ZEX0610/CareRover/main-web/docs/wireless-acceptance.md

> 本文描述原 `integration=legacy` 无线阶段。新人物/运动集成见 [跟随开发说明](tracking-development.md)；软件验证与真机验收分别记录。

# 无线阶段验收记录

本文件区分代码证据与真机证据。当前所有硬件场景均 **待 Windows 验收**；没有把本地模拟或编译当成真机通过。

| 阶段 | 代码与本机验证 | Windows 真机状态 |
|---|---|---|
| 0 基线 | 交接网页适配已合并；测试通过；原分区表已固定 | 待原工程配置、原固件重新编译结果 |
| 1 AP | 已实现，包含安全任务和串口诊断 | 待连接热点及原传感器/OLED回归 |
| 2 FFat HTTP | 已实现；镜像生成并反向解析逐文件校验 | 待实际挂载、独立供电网页加载 |
| 3 只读 WS | 已实现；25 Hz PPG、独立新鲜度、立即 ping | 待 10 分钟真机只读报告 |
| 4 控制 | 已实现；仅测试目标，拒绝自主模式 | 待真实 `/ws` ACK/目标回显检查 |
| 5 安全 | 固件共享逻辑主机测试及 20 组故障断控断言通过 | 待硬件 20 组报告、物理断网/掉电/拥塞测试 |

## 本机验证方法

- `npm test`：网页既有行为，以及 null 清除、控制者权限、新鲜度独立、错误关联。
- Python unittest：USB 适配、模拟器网络回归、烧录配置/分区/载荷边界。
- C++：直接测试固件状态机，包含命令边界、CAM 独立超时、模式清零、权限、急停跨连接、故障优先级、64 位时钟、深度和帧大小保护。
- ESP32 编译：明确未核实的 Core 3.3.10 / SparkFun 1.1.2 开发配置，仅证明可编译。
- 浏览器：Mock 回归与注入测试遥测的 UI 验证；不宣称来自真机。

## 每次现场记录

```text
提交：
固件版本 / 网页版本：
Windows FQBN / Core / 传感器库版本：
主控型号及 Flash/PSRAM：
stage：
供电方式、是否断开主控 USB：
测试浏览器和设备：
结果：PASS / FAIL / NOT RUN
证据路径或日志摘要：
```

## 阶段门槛

1. 原主控重新编译成功；保存恢复镜像。新代码先 AP、再 HTTP、再只读 WS，逐级烧录验收。
2. 主控和 CAM 独立规范供电，无主控 USB；手机能连热点、访问完整页面；无互联网仍可用。网页串口诊断协议链接、JS/CSS、版本文件都能加载。
3. 连续 10 分钟读取；手势变化 2 秒内与 OLED 一致；HR、SpO2、SQI 与 OLED/串口一致；PPG 连续，采样率和批次正确。
4. 移开手指、弱信号、拔 MAX30102：旧 HR/SpO2 不继续显示为有效。拔 CAM：camera=false、手势失效；健康和安全任务继续工作；接回 CAM 不自动恢复 MANUAL。
5. 两个浏览器：只有所有者可控制；另一个按钮只读且固件返回 CONTROL_BUSY，但仍可急停。跟人/手势驱动返回 UNSUPPORTED_MODE。
6. 20 次测试后端异常：记录每次停止原因、设备最后命令时间与停止时间。任何超过 250 ms、保留非零目标或自动恢复运动都失败。
7. 人工分别关闭页面、断手机 Wi-Fi、断浏览器设备电源、停止发命令、刷新急停页面、断开所有者。恢复连接后保持零目标；急停锁不自行解除。
8. 并发重复加载网页、慢读 WS、Wi-Fi 干扰：允许网络降低刷新或断开，采样不中断，安全任务间隔不超过预留 10 ms、命令超时归零不超过 250 ms；若不满足，记录并修复后重测。
9. FFat 无载荷或损坏场景使用专门测试板/已有备份：串口明确报错，不自动格式化。恢复正确载荷后重新验证。

任一失败保留 FAIL，不用重跑成功结果覆盖故障记录。先定位、修复、关联新提交再复测。只有阶段 0–5 全部通过才可完成总 goal；实际执行器验证属于后续目标。

## 2026-09-11 本机执行结果

- 网页 Node：11/11 通过；Python：16/16 通过。
- C++ 固件状态机/帧保护：全部断言通过，含 20 组独立故障场景。
- ESP32 Core 3.3.10 + SparkFun 1.1.2：stage 5 编译通过，使用 compile_only 配置；无设备连接、未烧录。
- FFat：镜像反向解析，所有生成的网页文件逐字节一致。
- Playwright：Mock 无控制台错误；注入测试遥测验证立即 ping、只读权限、自主模式禁用和独立 null 清除；桌面与 390px 手机视口已检查。该浏览器验证不使用真机数据。
- 现场只读 soak、真实 `/ws` 异常矩阵与物理故障测试：NOT RUN。
