ZEX0610/CareRover/watch-prototype/docs/LOCAL_PROGRESS.md

# 本机开发进度 · 2026-09-24

## 已核实

- 用户确认电池为 3.7 V 250 mAh，照片为带保护板 602025，约 26×20×6 mm。
- 用户确认 MAX30102 贴右腕手背侧皮肤。
- 本地电源板商家图片、MAX 模块手册/2D 图/原理图、MPU6050 资料、ESP32-S3 Zero 资料已检查。MAX 原理图显示 I²C 外侧可能上拉到板内 5 V，因此直连 3.3 V GPIO 处于待电气验证状态。
- 独立手表草图、运动算法、PPG 演示估计、协议和现场验收文档已写入本目录；没有修改小车两板固件。
- 本机 C++14 回归测试通过：模拟抬臂、归中、左右肩转、正反手腕横滚、IMU 180 ms 超时；合成 PPG 约 75 BPM、91% 演示 SpO2；协议生成/缓冲区边界通过。
- Arduino CLI 对 `esp32:esp32:waveshare_esp32_s3_zero` 编译成功（esp32 3.3.10、SparkFun MAX3010x 1.1.2）：448148 B 程序、33312 B 全局 RAM。首次构建使用中文输出路径在链接时失败，换英文临时 `--build-path` 后成功；详情见 README。

## 尚未核实

- 设备未到货，故不存在真实 GPIO、I²C、电流、充电、佩戴 PPG、Wi-Fi 丢包和运动方向实测通过。
- 小车主板没有 `watch_v1` 接收器；网页/OLED 也没有手表数据源显示。留待手表台架通过后集成。

## 下一次接续从这里开始

1. 到货后先量电源板 USB 充电/升压输出和 MAX SDA/SCL 空闲电平，再决定能否直连。
2. 按 `WIRING_AND_BENCH_PLAN.md` 的六级顺序做实物验收，留存波形、电流、温度、动作方向与无线包间隔。
3. 手表稳定后，才按 `INTEGRATION_CONTRACT.md` 修改小车主控及网页/OLED，先架空车轮验收。
