ZEX0610/CareRover/watch-prototype/max_schematic_review.png

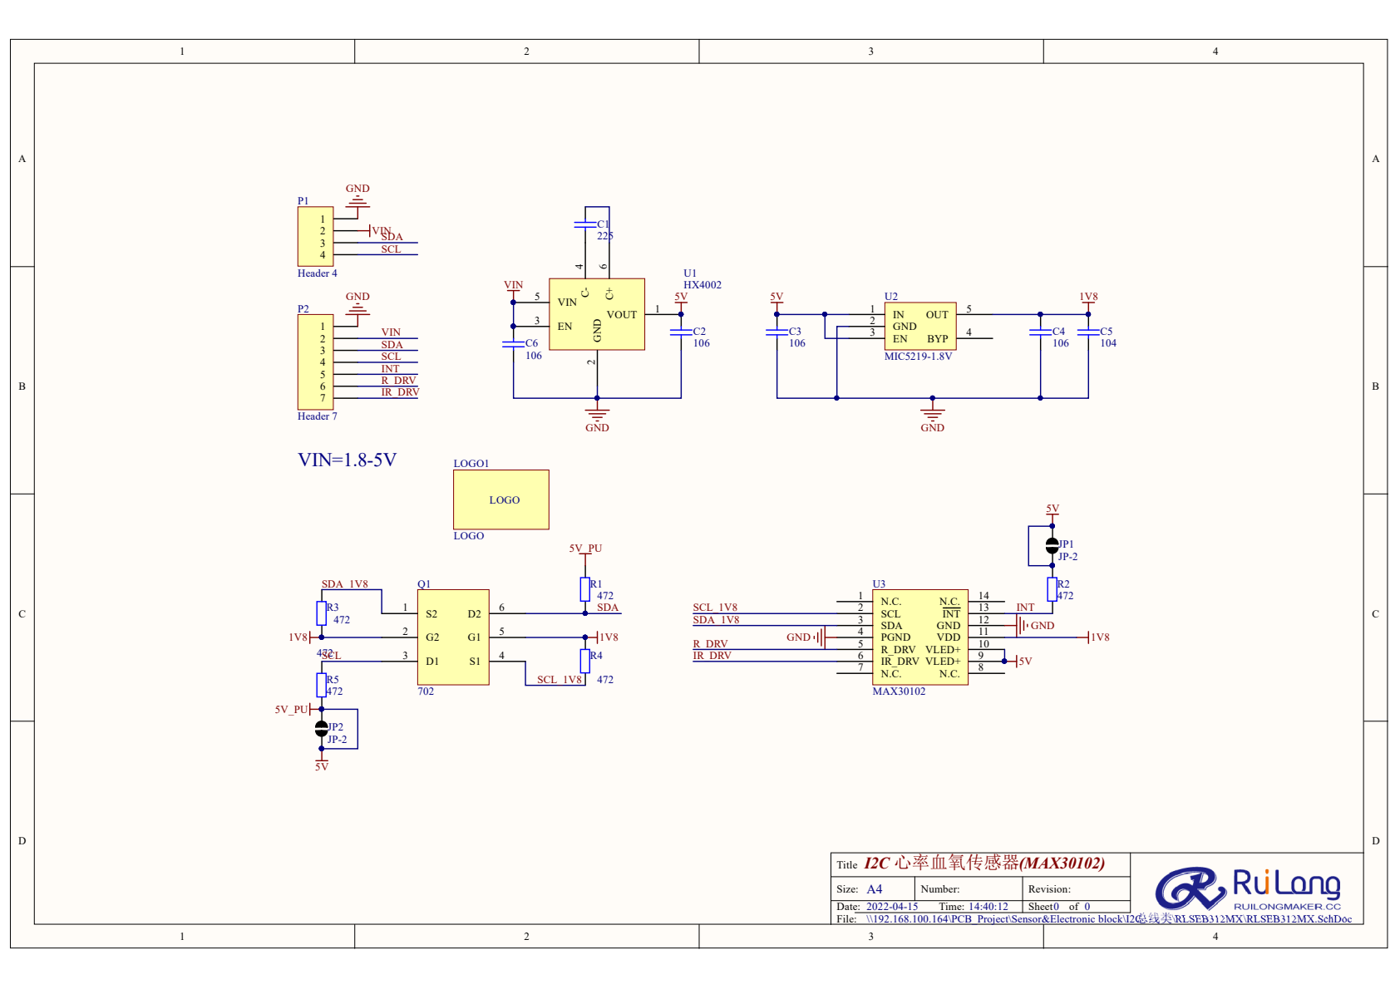
watch-prototype/max_schematic_review.png
