ZEX0610/CareRover/watch-prototype/docs/WIRING_AND_BENCH_PLAN.md

# 腕带结构、接线与到货后的逐级测试

## 1. 先确定机械姿态

面向佩戴者：右手向前平举、手背向上；MPU6050 与手背保持相对固定。目标传感器坐标为 `+X` 指向手指、`+Y` 指向右手拇指、`+Z` 远离皮肤。实际 GY-521 板上的 X/Y 丝印方向若不符，优先调整安装，不能凭照片默认为正确；装反时在软件里做三轴符号/轴置换再重新测试。

建议沿前臂长轴依次布置：腕部内侧窗口为 MAX30102，背皮肤侧仅留感光开口及柔软遮光圈；其 PCB 其他元件与皮肤间加薄绝缘/缓冲。MPU 固定在外壳平面，避免线材拉扯使其相对手臂摆动。ESP32-S3 Zero 天线端放在远离电池金属保护板及身体的一端，USB-C、BOOT 和电源开关均可从外壳外触及。电池与电源板隔离安放，禁止硬板边缘压迫软包电池。先做松散台架，再定制外壳；不建议在尺寸和发热未验证前上下叠压紧贴皮肤。

资料尺寸：电池照片为约 26×20×6 mm；ESP32-S3 Zero 官方尺寸约 23.5×18 mm；电源板商家图约 30×10×9 mm；MAX 商家手册写 26×41 mm，而 2D 图给出了 36、26、30 mm 标注，**以到货尺量为准**。佩戴宽度可能主要受 MAX 模块决定。

## 2. 电气接线表（先验证，后永久焊）

| 源 | 去向 | 备注 |
|---|---|---|
| 602025 电池红/黑 | 电源板 `B+`/`B-` | 先核对正负极和电池保护板。不要焊接/短接电池本体。 |
| 电源板经开关后的**实测 5 V** 输出和 GND | ESP32-S3 Zero `5V` 与 `GND` | 商家板标有 `M+ / M-`、`U+ / U-`；实物未测前不能认定哪对是 5 V 或受开关控制。**不可**把 3.7 V 电池直连 5V 焊盘，也不可把 5 V 接 3V3。 |
| ESP32 `3V3`、`GND` | MPU `VCC`、`GND` | 共地；尽量短线、固定防拉断。 |
| ESP32 `GPIO4`、`GPIO5` | MPU `SDA`、`SCL` | MPU `AD0` 接 GND（0x68），`XDA/XCL/INT` 留空并绝缘。 |
| ESP32 `3V3`、`GND` | MAX 模块 `V/VCC`、`G/GND` | MAX 四脚排针定义为 G、V、D、C；只在供电/纹波测量合格后焊。 |
| ESP32 `GPIO4`、`GPIO5` | MAX 模块 `D/SDA`、`C/SCL` | **仅当空闲 SDA/SCL ≤3.3 V 时可直连**；否则先改造 5 V 上拉或加入小型双向电平转换器。 |

### MAX 模块需要特别量电压

商家原理图 `RLSEB312MX_SCH.pdf` 表明：模块将 VIN 升为内部 5 V，I²C 外侧的 SDA/SCL 经 472 上拉到 `5V_PU`，`JP2` 连接 `5V_PU` 与内部 5 V。故“VCC 接 ESP32 3.3 V”**不意味着**数据脚为 3.3 V。先不接 ESP32 的 SDA/SCL，只给 MAX 模块 VCC/GND 供电，以万用表量 SDA、SCL 对 GND 的空闲电压。高于 3.3 V 时，优先在外部使用双向 I²C 电平转换器（MAX 侧 HV=实测 5 V、ESP32 侧 LV=3.3 V，并共地）；若采用拆除 JP2、更换上拉的精细改板方式，必须看实板、断电测通断、上电复测两线 ≤3.3 V。未确认前不直连 GPIO。不能将 ESP32 3V3 接到 MAX 内部 5 V 电源节点。

原理图已渲染为本目录上一层的 `max_schematic_review.png`，可直接放大看 JP2、R1/R5 与 MOS 电平转换部分。

电源板卖家只给了图片，没有明确的充电电流、升压峰值、欠压策略。250 mAh 电芯所允许的充电电流须以电池和电源板规格及实测为准；未确认前只做 USB 限流台架检查，**不要边充电边佩戴**。首次上电检查空载 5 V、3.3 V，随后检查 ESP32 Wi-Fi 连接/发送瞬态电压及电源板温升。USB 电脑连接与外部 5 V 同时存在时，若板上无明确电源隔离电路，先断开外部升压 5 V 再插 USB 调试，避免 5 V 反灌。

## 3. 直焊导线而非排针

台架先用临时线和绝缘夹具验证全部引脚。确认无误后，用细软硅胶线对每个焊盘点焊、热缩管单独绝缘，并在 PCB 边缘做应力释放。红/黑分别标记正负，SDA/SCL 用不同颜色；每根线接线后用万用表查短路及拉力。贴肤面用不透光、低刺激且可拆洗的遮光垫圈包围感光窗口；镜片不应被胶封住。留透气与散热间隙，不让热的电源板贴皮肤。穿戴与运动数据测试先用低功率 USB/实验电源完成，最后再接电池。

## 4. 分阶段验收，不跳过失败项

1. **空载电源**：量电池极性、板上各焊盘电压、开关关断后的输出、USB 充电电流及板温。任何 5 V 欠压/过压、异常发热先停。
2. **仅 ESP32**：用 USB 在 Arduino IDE 烧录串口草图，115200 确认 `watch_v1`、BOOT 短按释放时 `RECENTER`。断 USB 后改由升压 5 V 单独供电，测 Wi-Fi 发包时 5 V 与 3V3 最低值、平均/峰值电流和重启次数。
3. **仅 MPU**：确认 I²C 地址 0x68、坐标轴符号；水平前举静止约 1 秒完成归中，再做抬/落、左右肩旋转、双向手腕横滚。抓取串口 JSON，逐项看 `vx/vy/wz` 符号、180 ms IMU 失联清零、再次归中。记录陀螺零漂，尤其左右控制在 30 秒内是否需要归中。
4. **仅 MAX**：先测 SDA/SCL 高电平，再接 I²C。检查 0x57、实际 FIFO 25 Hz、有手腕/无手腕的 IR DC、波形和接触噪声。静坐至少 2 分钟，与可信指夹式仪器比对 HR/SpO2；再分别做轻摆、剧烈动作、松紧带变化，记录“当前有效”“保持上次值”“无数据”的变化。若腕部 SpO2 偏差大，不得以降低阈值掩盖偏差；可展示 HR 和波形，SpO2 标记演示/未校准。
5. **联合供电**：MPU+MAX+Wi-Fi 同时运行 10 分钟，记录 I²C 失败、FIFO 溢出、串口包间隔、掉线重连、最大温升和电池耗电。用实际平均电流估算续航：约 `250 mAh ÷ 实测 mA`，再为升压损耗与电压截止留余量，不凭容量数字宣称续航。
6. **穿戴动作与无线**：每种动作 20 次，确认指令方向和静止误触率。由于六轴不能长期观测绝对航向，左右肩转控制采用短时相对角；换站位/漂移时按 BOOT 归中，量化归中间隔。此阶段通过后再修改小车固件。
