ZEX0610/CareRover/audio-lab/docs/WIRING_AND_TEST.md

# 音频模块接线、电源与现场分阶段验收

## 与当前小车的引脚对照

从 `C:\CareRover\docs\wiring-current.md` 和主板实际 `front_config.local.h` 核对：OLED=4/5，MPU6050=6/7，MAX30102=8/9，四轮=10/12/13/11，HC-SR04=14/15，CAM UART=17/18，原生 USB=19/20。现场确认 INMP441 的 SCK/WS **已经**分别占用 GPIO1/2，用户不希望把功放时钟再接到这两脚。主板引脚图在 `ESP32-S3开发\ESP32-S3开发板\ESP32-S3引脚图1.png`；功放选用 GPIO39/42，当前其他固件功能未占用。**接线前仍需按手里的同款主板丝印复核**；GPIO39/42 若将来启用外部 JTAG，则需要重新分配。

| 信号 | 独立实验 ESP32-S3 主板 | INMP441 / MAX98357 模块 |
|---|---:|---|
| 麦克风 I²S BCLK/SCK | GPIO1（已接） | 仅接 INMP441 `SCK` |
| 麦克风 I²S WS | GPIO2（已接） | 仅接 INMP441 `WS` |
| 麦克风数据输入 | GPIO16 | INMP441 `SD` → GPIO16 |
| 功放 I²S BCLK | GPIO39 | 仅接 MAX98357 `BCLK` |
| 功放 I²S LRC/LRCLK | GPIO42 | 仅接 MAX98357 `LRC/LRCLK` |
| 扬声器数据输出 | GPIO21 | GPIO21 → MAX98357 `DIN` |
| 功放开关 | GPIO38 | GPIO38 → 1 kΩ → 功放 `SD/SD_MODE`；`SD` 对 GND 加 10 kΩ 下拉，防止开机时默认响 |
| 麦克风声道 | — | INMP441 `L/R` → GND（左声道） |
| 麦克风电源 | 主板 3.3 V | `VDD/VCC` → 3.3 V，`GND` → 主板 GND；**不能接 5 V** |
| 功放电源 | 新电源模块独立 5 V | `VIN/VCC` → 新模块 5 V，`GND` →公共 GND |
| 扬声器 | — | 3 W/8 Ω 扬声器两线分别接 `OUT+`、`OUT−`；**任一喇叭线都不能接 GND** |

麦克风 RX 用 I²S0，功放 TX 用 I²S1，分别由现有 GPIO1/2 与新增 GPIO39/42 输出时钟；**四根线都单独接，不共接任何时钟 GPIO**。两路音频通过队列交换 20 ms 帧，并不要求两组时钟物理同步。不需要 MCLK。模块原理图 `MAX98357_TEST扬声器\MAX98357_TEST\原理图.png` 标明 SD_MODE 有 1 MΩ 上拉、GAIN 悬空（9 dB）、OUTP/OUTN 为桥接输出；若实物板的丝印/元件与图不同，以实物核查为准。MAX98357 **A** 接标准 I²S；若实物芯片尾字是 **B**，B 型的数据格式不同，应先确认型号再上电。商家旧图使用经典 ESP32 的 GPIO22/25/26/34，不能照搬到本项目 ESP32-S3。麦克风本地规格书在 `INMP441全向麦克风资料(1)\INMP441全向麦克风资料\INMP441.pdf`，供电允许 1.62–3.63 V，输出为 24 位数据、32 位声道槽，因此实验固件用 16 kHz×双声道×32 位，即每路 1.024 MHz BCLK。[TDK 原规格书](https://invensense.tdk.com/wp-content/uploads/2015/02/INMP441.pdf)、[ADI MAX98357 规格书](https://www.analog.com/media/en/technical-documentation/data-sheets/MAX98357A-MAX98357B.pdf)、[乐鑫双向 I²S 文档](https://docs.espressif.com/projects/esp-idf/en/latest/esp32s3/api-reference/peripherals/i2s.html)。

## 两块电源模块怎么分

```text
旧模块 5 V ── 四个 MG90S 舵机（现有线路，原样保留）
新模块 5 V ── MAX98357 功放 VCC（先只给音频功放供电）
主板 USB 或已验证的主板电源 ── ESP32-S3 ── 3.3 V → INMP441
旧模块 GND ─┬─ 主板 GND ── CAM/传感器 GND
新模块 GND ─┘
```

两路 **GND 共地**，旧/新模块的 **5 V 正极互不相连**、3.3 V 输出也不并联，扬声器两线只接功放输出。当前 USB 调试主板/CAM 时，USB 的 5 V 与新旧模块 5 V 不相接；不能从两处同时灌同一 `5V` 引脚。今后脱离 USB，应先现场明确主板与 CAM 各自的稳压供电额定能力、保险/开关和电源分配，再决定是否迁移；不能因为多买一块电源就默认四舵机、CAM、主板和功放能同时稳定工作。

用户给出的扬声器是 **3 W/8 Ω**。3 W 是扬声器承受能力，不等于该功放在 5 V/8 Ω 能给出 3 W；MAX98357 数据表给出的 8 Ω 典型输出约 **1.8 W（10% THD+N）**。新模块每个 5 V 口、升压总路、电池瞬态能力要以实测为准，开始时用实验固件的 `/6` 幅度、功放默认 9 dB，不要直接满幅。[ADI 规格书](https://www.analog.com/media/en/technical-documentation/data-sheets/MAX98357A-MAX98357B.pdf)

布线建议 I²S 线尽量短（首测 <10 cm，最终尽量 <15 cm），BCLK 附近有地线返回；功放/扬声器线与麦克风分开走，麦克风远离舵机和喇叭、避免喇叭正对收音孔。必要时在功放 5 V 近端加 100 µF 以上低 ESR 储能电容及 0.1 µF 去耦；商家板已有 0.1 µF/10 µF，但长线和电源脉冲仍要示波或万用表核查。

若直接焊线而不装排针：先断电核对焊盘丝印、导线颜色和极性，再给线根部热缩/点胶做应力释放；通电前用万用表确认 3.3 V、5 V、GND 互无短路，扬声器两线与 GND 绝缘。不要把数据表芯片脚号当成商家模块焊盘顺序。

## 阶段测试（每步记录 PASS/FAIL/NOT RUN）

1. **不接现有整车**：借用备用同型号 ESP32-S3 主板或预先备份后明确允许临时替换固件；把扬声器和功放 5 V 先断开。核对 VDD/GND、模块 A/B 版本、喇叭标签、空闲 GPIO、两路 5 V 无相通。
2. Arduino IDE 选 ESP32S3 Dev Module / 16 MB Flash / OPI PSRAM / 115200，编译并上传**独立草图到备用板**。串口输入 `mic`，说话、安静各 10 秒；预期 `capture_fps≈50`，`mic_rms` 对说话有明显变化。若一直 0，先查 L/R 接地及 GPIO16，而非增大扬声器功率。
3. 功放新模块 5 V 上电，先查主板 3.3 V 与功放 5 V 稳定、共地、SD 默认被 10 kΩ 拉低。串口输入 `tone`，预期低音量 440 Hz；`idle` 应静音。输入 `loop` 可短时自听，喇叭与麦克风分开以免啸叫。记录 5 V 波动、重启、噪声、温升。
4. 本机先跑 `npm test` 验证协议。配置公网 HTTPS/WSS 中继与两个独立随机令牌；把备用板设为 `remote`，用另一台设备打开中继 HTTPS 页。测试“孩子说→家长听”“家长按住→小车播”“家长松开→小车不再播”，各 1 分钟；记录端到端时延、断线恢复、音频缺口/回声。当前音频固件 `remote` 采用 **纯 STA**，不会承载小车现有 AP/视频/控制；这是隔离验证，不代表整车集成。
5. **以后才做整车集成**：先保存两板 Flash/NVS 与网页版本；在现有主板固件里接入 I²S/队列/WSS，并保留 AP+STA/Server酱、CAM 与控制协议。比较加音频前后视频实际帧率、人物/手势推理、摇杆 P95 延迟、最低空闲堆、掉帧/断线、舵机电压与消息推送。测试观测期至少 10 分钟，包含真实小车运动、跟随、双向说话。当前这一步 **NOT RUN**。

音频有回声时先改半双工按住说话、麦克风/扬声器位置和物理隔声。要真实免提同时说话，需加入 AEC 并复测 CPU/PSRAM；不能把单麦克风+单功放的裸 PCM 原型称为已完成高质量全双工通话。
