ZEX0610/CareRover/main-web/docs/test-checklist.md

# 验收记录

日期：2026-09-09。范围：本地 Mock 控制台，未接入真实硬件。

## 自动检查

执行：

```bash
node --test tests/*.test.js
.venv/bin/python -m unittest discover -s tests -p 'test_*.py' -v
```

当前覆盖 8 项 Node 测试、5 项 Python 测试：

本地两套检查均通过；功能提交 `00a7e5a` 的 [GitHub Actions 检查](https://github.com/NeedleAss/spider-webite-dev/actions/runs/34332275913) 在 Ubuntu / Node 22 / Python 3.12 上同样通过。

- [x] 4:3 源图像在 16:9 / 纵向容器中的 contain 缩放与黑边偏移。
- [x] 摇杆八方向、归一化、死区、半径限制与坐标符号。
- [x] 非法 JSON、异常 ACK、无效样本、非法速度和过大包被处理。
- [x] 完整且新鲜的机器人状态、在线设备链路是运动前提。
- [x] 迟到 telemetry 不清除本地急停；仅健康 telemetry 不续期手动许可。
- [x] 5 分钟、50 Hz 样本量下 PPG 固定容量，无无限增长的数据数组。
- [x] ESTOP 硬停车、禁止非零命令、明确恢复到 IDLE。
- [x] 250 ms watchdog 超时归零。
- [x] Mock 定时任务句柄不累计；断线恢复不会继承原运动。
- [x] pointerup / pointercancel / lostpointercapture / blur / hidden 释放输入。
- [x] 第二个指针不能抢占摇杆；旋转取消归零；键盘释放归零。
- [x] 实际 WebSocket 命令 → ACK → telemetry，PPG batch 及 MJPEG JPEG 帧。
- [x] 多客户端控制权互斥，其他客户端仍可急停。
- [x] 服务不公开 .git / .env / .venv，拒绝异源网页申请控制连接。

## 浏览器实测

本机 Chromium 内嵌浏览器，使用实际页面和实际 Python 服务：

- [x] 默认 Mock 页面成功连接，人物框 / 手势 / HR / SpO₂ / SQI / 波形持续更新。
- [x] 真实 `?transport=ws` 模式连接 `/ws`，`/stream` 显示连续模拟画面。
- [x] 拖动右上产生正 vx 和正 vy，松手后界面与机器人回显均归零。
- [x] 模式以回报确认；FOLLOW 禁用手动控制。
- [x] 红色急停锁定所有运动，确认解除后回到待机。
- [x] WebSocket 模式按住右转后 yaw 增加，释放后 wz 归零。
- [x] 速度滑块可设为 20%。
- [x] 模拟断线显示 RECONNECTING，恢复回 IDLE。
- [x] 实际停止 Python 服务后锁定输入、等待视频；重启服务后连接与 MJPEG 自动恢复，原输入不恢复。
- [x] 录制并导出本地 JSON（实测 1007 条消息，含 telemetry / ppg_batch / pong）；本地回放显示录制状态且禁用运动，可返回实时。
- [x] 自行生成 640×360 MP4，实际选择文件后正常播放；本地视频用归一化 metadata 映射到实际视频显示区域。
- [x] 中文 / 英文切换，英文急停及解除按钮在 320px 窄屏未溢出。
- [x] 正常启动与操作未出现应用 JS 错误。人为停服时网络错误是预期结果。

| 视口 | 页面横向溢出 | 控制区溢出 | 急停可见 |
| --- | --- | --- | --- |
| 1920×1080 | 无 | 无 | 是 |
| 1366×768 | 无 | 无 | 是 |
| 820×1180 | 无 | 无 | 是 |
| 390×844 | 无 | 无 | 是 |
| 320×640 | 无 | 无 | 是 |

小屏和紧凑笔记本页面可纵向滚动。底部固定栏始终保留模式和急停。

### 连续运行观察

最终页面在 1920×1080 内嵌 Chromium 中实际连续运行 312 秒，浏览器 Mock 以 50 Hz 产生 PPG。调试面板读取结果如下；JS 堆数值来自 Chromium 的近似 `performance.memory` 指标。

| 运行时间 | PPG 缓冲 | 界面 FPS | JS 堆 |
| --- | --- | --- | --- |
| 启动 | 10 / 4096 | 初始化 | 21.4 MiB |
| 199 秒 | 4096 / 4096 | 49 | 23.3 MiB |
| 237 秒 | 4096 / 4096 | 48 | 21.3 MiB |
| 291 秒 | 4096 / 4096 | 50 | 22.2 MiB |
| 312 秒 | 4096 / 4096 | 56 | 21.1 MiB |

缓冲保持固定容量，采样点未观察到堆持续增长，波形与遥测正常更新；本次运行无控制台错误或警告。FPS 为当前自动化内嵌浏览器读数，并非所有设备的性能保证。

## 明确边界

- 触摸以 Pointer Events 输入路径和移动视口检查覆盖；尚未在实体手机上做手指拖动验收。
- 五分钟样本测试、实际持续运行和定时器检查提供容量与运行观察；近似堆读数不是完整浏览器内存剖析报告。
- 本地测试视频用于播放和坐标检查，不代表真实人物检测。
- 尚未验证 ESP32 固件、真实传感器、物理急停距离、串口链路或实际网络性能。硬件到货后按下面清单继续。

## 硬件阶段清单

- [ ] CAM 静态资源与正确的 JS MIME 类型。
- [ ] 真正 MJPEG 画面与 bbox 源分辨率、宽高比一致。
- [ ] 主控独立 250 ms watchdog 和 ESTOP 锁定。
- [ ] UART 断开 / MCU 故障时停止。
- [ ] 实际手机触摸、锁屏、切后台、Wi-Fi 漫游。
- [ ] 视频 / AI / 健康各自频率下的数据新鲜度。
- [ ] 局域网多客户端控制权仲裁。
