ZEX0610/CareRover/main-web/firmware/main_wireless/dog_animation_assets.h

#pragma once

#include <Arduino.h>

static constexpr uint8_t DOG_FRAME_WIDTH = 72;
static constexpr uint8_t DOG_FRAME_HEIGHT = 56;
static constexpr uint16_t DOG_FRAME_BYTES = 504;
static constexpr uint8_t DOG_FRAME_COUNT = 8;

static const uint8_t PROGMEM DOG_ANIMATION_A[DOG_FRAME_COUNT][DOG_FRAME_BYTES] = {
  {
    0x00, 0x00, 0x00, 0x00, 0x00, 0x00, 0x00, 0x00, 0x00, 0x00, 0x00, 0x00, 0x00, 0x00, 0x00, 0x00, 0x00, 0x00,
    0x00, 0x00, 0x00, 0x00, 0x00, 0x00, 0x00, 0x00, 0x00, 0x00, 0x00, 0x00, 0x00, 0x00, 0x00, 0x00, 0x00, 0x00,
    0x00, 0x00, 0x00, 0x1F, 0x00, 0x00, 0x00, 0x00, 0x00, 0x00, 0x00, 0x00, 0x7F, 0x00, 0x00, 0x00, 0x00, 0x00,
    0x00, 0x00, 0x00, 0xE1, 0x00, 0x00, 0x00, 0x00, 0x00, 0x00, 0x00, 0x00, 0xC3, 0x8C, 0x00, 0x00, 0x00, 0x00,
    0x00, 0x00, 0x01, 0x8F, 0xDF, 0x0F, 0xC0, 0x00, 0x00, 0x00, 0x00, 0x01, 0x9C, 0x07, 0xBF, 0xC0, 0x00, 0x00,
    0x00, 0x00, 0x01, 0x80, 0x00, 0xA0, 0x60, 0x00, 0x00, 0x00, 0x00, 0x01, 0xC0, 0x00, 0x00, 0x60, 0x00, 0x00,
    0x00, 0x00, 0x01, 0xC0, 0x00, 0x00, 0x60, 0x00, 0x00, 0x00, 0x00, 0x01, 0x80, 0x00, 0x00, 0x60, 0x00, 0x00,
    0x00, 0x00, 0x03, 0x00, 0x00, 0x00, 0x60, 0x00, 0x00, 0x00, 0x00, 0x06, 0x00, 0x00, 0x01, 0xE0, 0x00, 0x00,
    0x00, 0x00, 0x06, 0x1B, 0x00, 0x07, 0xC0, 0x00, 0x00, 0x00, 0x00, 0x06, 0x03, 0xB0, 0x02, 0x00, 0x00, 0x00,
    0x00, 0x00, 0x06, 0x13, 0x00, 0x02, 0x00, 0x00, 0x00, 0x00, 0x00, 0x04, 0x1F, 0x98, 0x03, 0x00, 0x00, 0x00,
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
    0x00, 0x00, 0x00, 0x00, 0x00, 0x00, 0x00, 0x00, 0x00, 0x00, 0x00, 0x00, 0x00, 0x00, 0x00, 0x00, 0x00, 0x00,
    0x00, 0x00, 0x00, 0x00, 0x00, 0x00, 0x00, 0x00, 0x00, 0x00, 0x00, 0x00, 0x00, 0x00, 0x00, 0x00, 0x00, 0x00,
  },
};
