ZEX0610/CareRover/main-web/firmware/cam_tracking/main/video_server.h

#pragma once
#include "esp_camera.h"
#include <cstdint>
bool videoBegin();
bool videoPublish(camera_fb_t* frame);
uint32_t videoEncoded();
uint32_t videoDropped();
uint32_t videoLastEncodeMs();
uint32_t videoSent();
uint32_t videoCaptureFailures();
