ZEX0610/CareRover/audio-lab/firmware/audio_lab/audio_config.example.h

#pragma once

// Copy to audio_config.local.h for a stand-alone audio-board experiment.
// The local file is ignored by the audio lab's .gitignore; never submit keys.
#define AUDIO_WIFI_SSID ""
#define AUDIO_WIFI_PASSWORD ""
#define AUDIO_RELAY_HOST ""
#define AUDIO_RELAY_PORT 443
#define AUDIO_DEVICE_TOKEN ""
#define AUDIO_RELAY_ROOT_CA ""  // PEM root CA of the HTTPS/WSS relay.
