ZEX0610/CareRover/main-web/firmware/main_wireless/wifi_secrets.example.h

#pragma once
// Copy to wifi_secrets.h locally. Do not commit the real password or binaries containing it.
#define CAREROVER_AP_PASSWORD "REPLACE_WITH_PRIVATE_PASSWORD"
// WeChat (Server酱) push for seating detection.
#define CAREROVER_WECHAT_SENDKEY "REPLACE_WITH_SENDKEY"
#define CAREROVER_STA_SSID "REPLACE_WITH_HOME_WIFI_SSID"
#define CAREROVER_STA_PASSWORD "REPLACE_WITH_HOME_WIFI_PASSWORD"
