ZEX0610/CareRover/watch-prototype/firmware/CareRoverWatch/watch_secrets.example.h

#pragma once
// Copy to watch_secrets.h only after the car AP credentials are confirmed.
// Do not commit the real password. Empty SSID keeps the watch in serial-only mode.
#define WATCH_WIFI_SSID ""
#define WATCH_WIFI_PASSWORD ""
