ZEX0610/CareRover/(commit log)

2026-09-26 Add CareRover source-only review snapshot
    [partitions.csv]
2026-09-28 Document relay migration and point gateway to new host
